martinimaturana/Tesis-CNC-Control-Inteligente/README.md

# Tesis-CNC-Control-Inteligente (REPOSITORIO EN PROCESO)
Código fuente, modelos y telemetría de una plataforma CNC de arquitectura abierta (Raspberry Pi + ESP32) para la evaluación de controladores PID, FLC y ANFIS a 1 kHz.
