martinimaturana/Tesis-CNC-Control-Inteligente/hardware/Imagenes/acople_iman_nema11.png

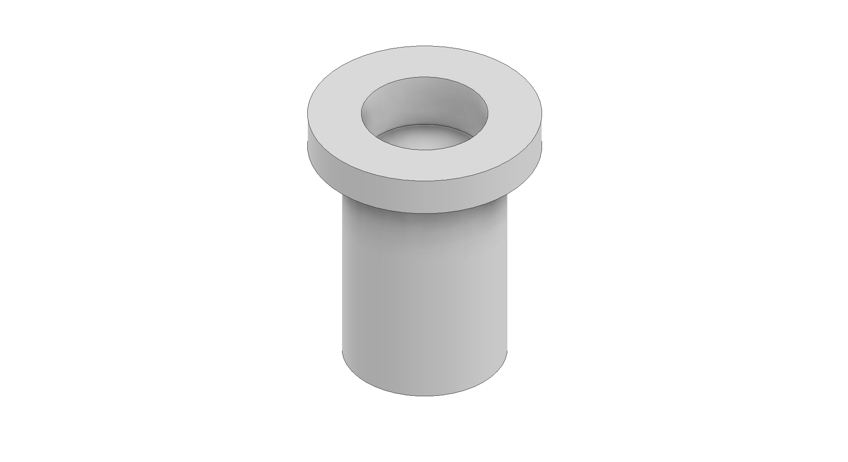
hardware/Imagenes/acople_iman_nema11.png
