martinimaturana/Tesis-CNC-Control-Inteligente/hardware/Imagenes/acople_iman_nema11_real.jpeg

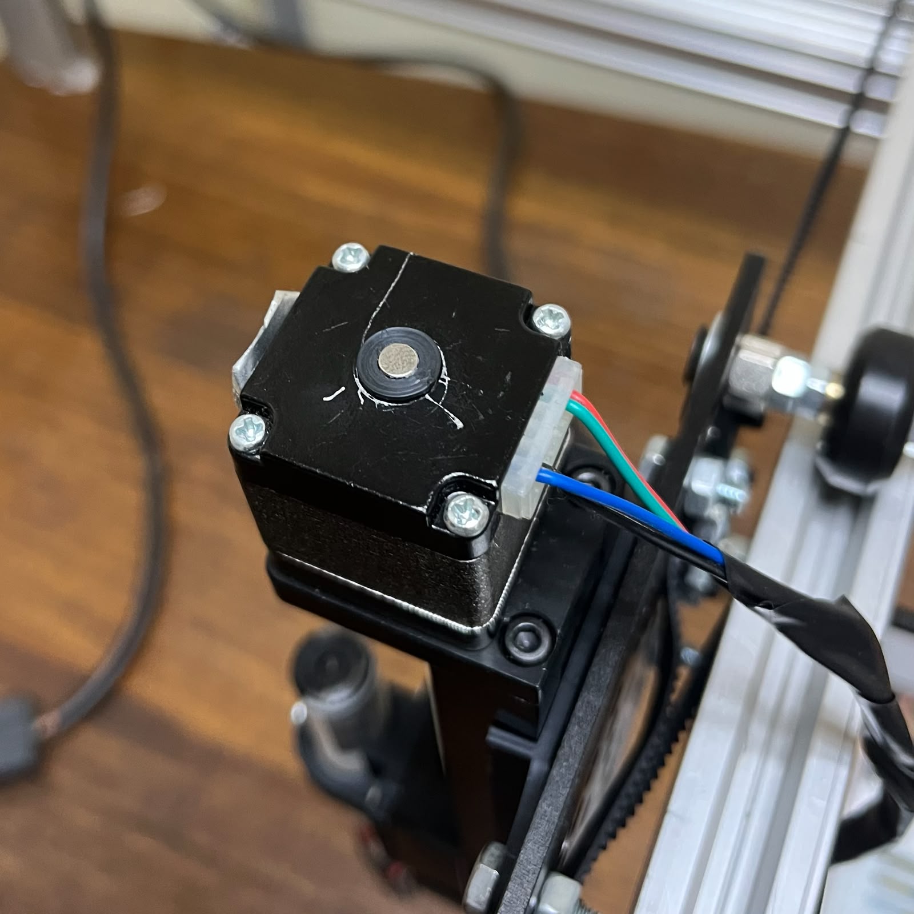
hardware/Imagenes/acople_iman_nema11_real.jpeg
