martinimaturana/Tesis-CNC-Control-Inteligente/hardware/Imagenes/acople_iman_nema23.png

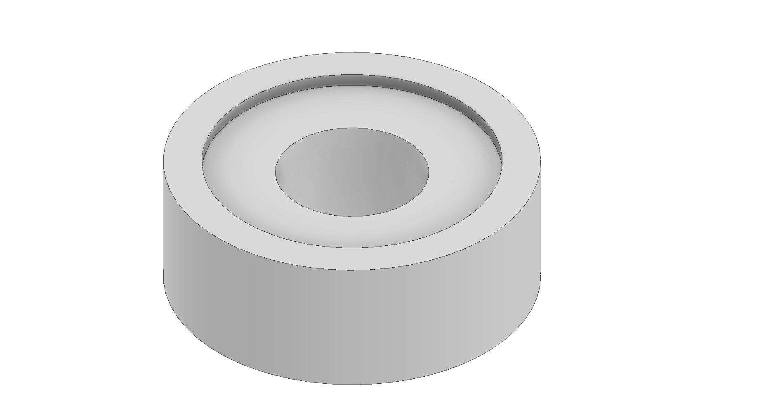
hardware/Imagenes/acople_iman_nema23.png
