martinimaturana/Tesis-CNC-Control-Inteligente/hardware/Imagenes/acople_iman_nema23_real.jpeg

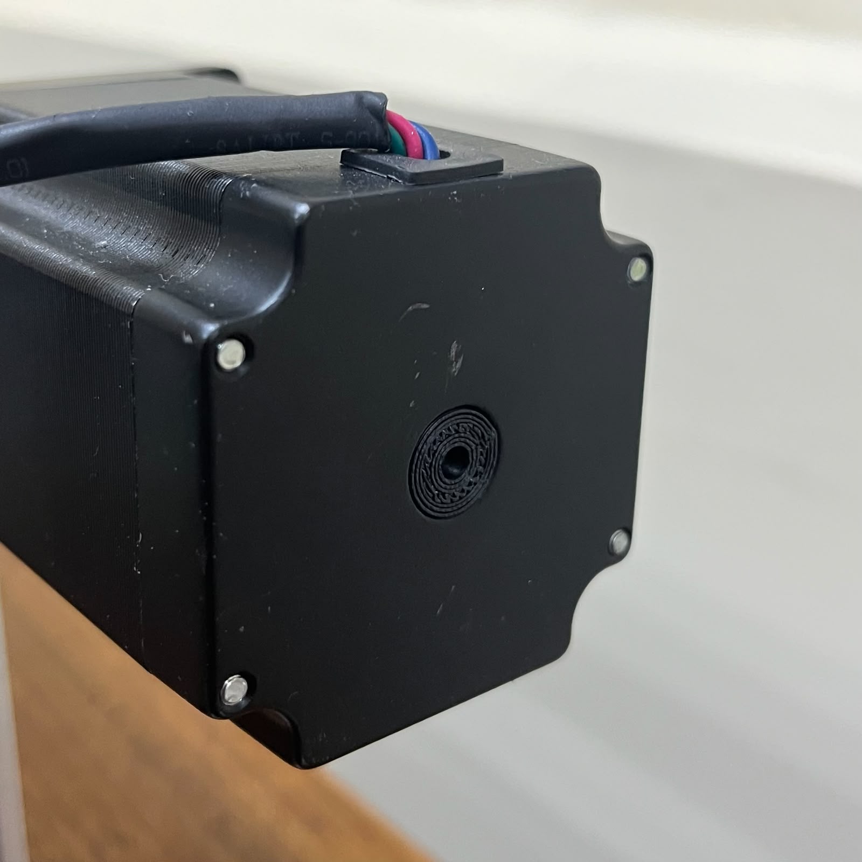
hardware/Imagenes/acople_iman_nema23_real.jpeg
