martinimaturana/Tesis-CNC-Control-Inteligente/hardware/Imagenes/driver_tb6600.jpg

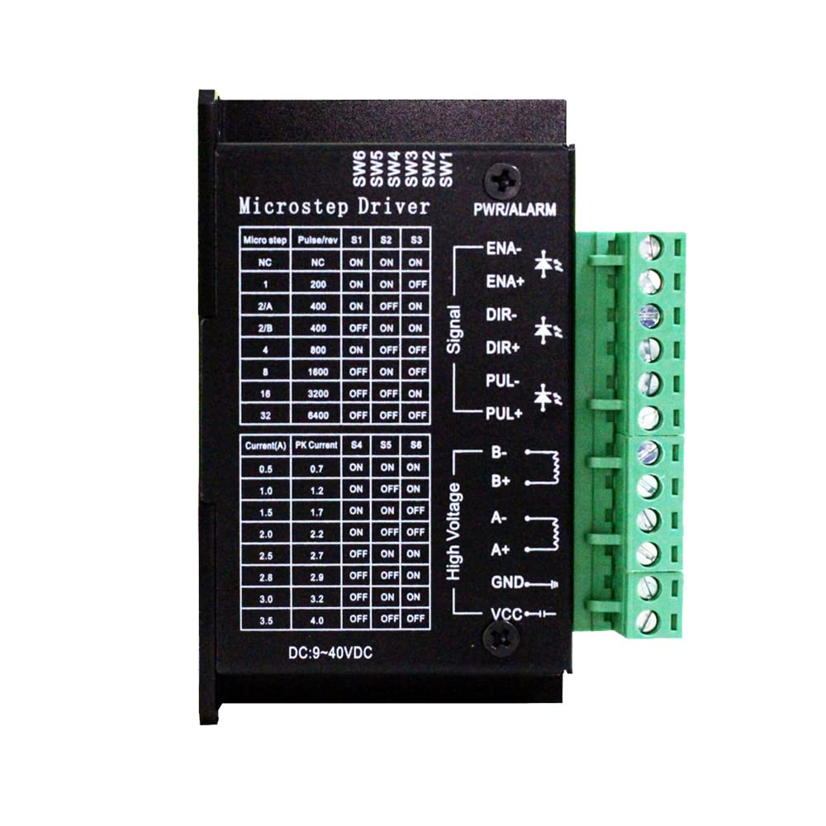
hardware/Imagenes/driver_tb6600.jpg
