martinimaturana/Tesis-CNC-Control-Inteligente/hardware/Imagenes/fuente_24v.jpg

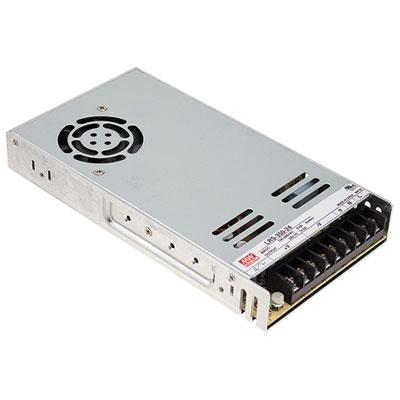
hardware/Imagenes/fuente_24v.jpg
