martinimaturana/Tesis-CNC-Control-Inteligente/hardware/Imagenes/modulo_xl4016.jpg

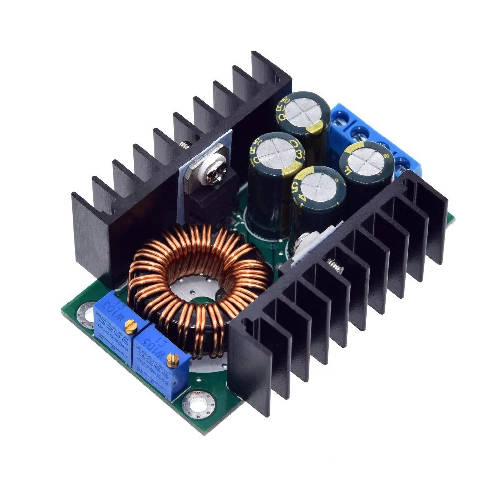
hardware/Imagenes/modulo_xl4016.jpg
