martinimaturana/Tesis-CNC-Control-Inteligente/hardware/Imagenes/raspberry_pi_4_b.png

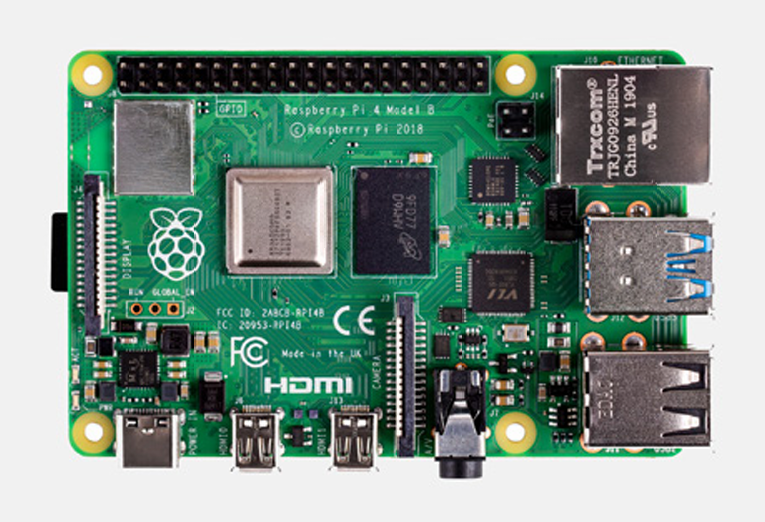
hardware/Imagenes/raspberry_pi_4_b.png
