martinimaturana/Tesis-CNC-Control-Inteligente/hardware/COSTOS_CNC.xlsx

Componentes CNC
N° | Componente | Cantidad | Precio Unitario | Total
1 | Motor Paso a paso Nema17 17HS3401S | 1 | $12000 | $12000
2 | ESP32 Devkit V1 30 Pines | 1 | $8000 | $8000
3 | Correa dentada GT2-6 100mm | 2 | $1000 | $2000
4 | Cables dupont macho macho | 40 | $30 | $1200
5 | Cables dupont macho hemnbra | 40 | $30 | $1200
6 | Cables dupont hembra hembra | 40 | $30 | $1200
7 | Encoder magnetico AS5600 | 3 | $1982.25 | $5946.75
8 | Perfil aluminio 40x20x700 | 1 | $11500 | $11500
9 | Perfil aluminio 40x40x35 | 1 | $2800 | $2800
10 | Kit Actuador C-Beam XL 1000 | 2 | $182000 | $364000
11 | 1kg Filamento PLA+ ENDER NEGRO | 1 | $10990 | $10990
12 | Polea dentada GT2-20 | 1 | $1200 | $1200
13 | Cables dupont 4 pines hembra hembra 70 cm | 2 | $1500 | $3000
14 | Cables dupont 3 pines hembra hembra 70 cm | 4 | $1500 | $6000
15 | Riel lineal T-type 100mm | 1 | $23720 | $23720
16 | Placa ranura V-Slot 20-80mm | 1 | $10672 | $10672
17 | Repartidor Bipolar 125a 7 Polos | 1 | $5350 | $5350
18 | Driver TTB6600 | 4 | $10290 | $41160
19 | INA219 | 4 | $2500 | $10000
20 | Fuente de Poder Mean Well LRS-350-24 – 350W 24VDC 14.6A | 1 | $29780 | $29780
21 | Raspberry pi 4 Model B 4GB RAM | 1 | $145990 | $145990
22 | Riel Din Perforado 35X7,5Mm Tira 1Mts | 1 | $1850 | $1850
23 | Canaleta ranurada W20XH30 2m Gris | 1 | $2850 | $2850
24 | Interruptor automático 1X16A | 1 | $5000 | $5000
25 | Módulo XL4016 300W 9A Step Down | Fuente CV/CC Ajustable | 1 | $5600 | $5600
26 | Mini protoboard 170 puntos | 1 | $990 | $990
27 | Tarjeta de Expansión con Borneras para ESP32 Versión 30 Pines | 1 | $3600 | $3600
28 | Pizarra Blanca 600x900 | 1 | $12480 | $12480
 |  |  | TOTAL | $730078.75
