martinimaturana/Tesis-CNC-Control-Inteligente/hardware/STLs hardware mecanico/acople as5600 nema17.stl

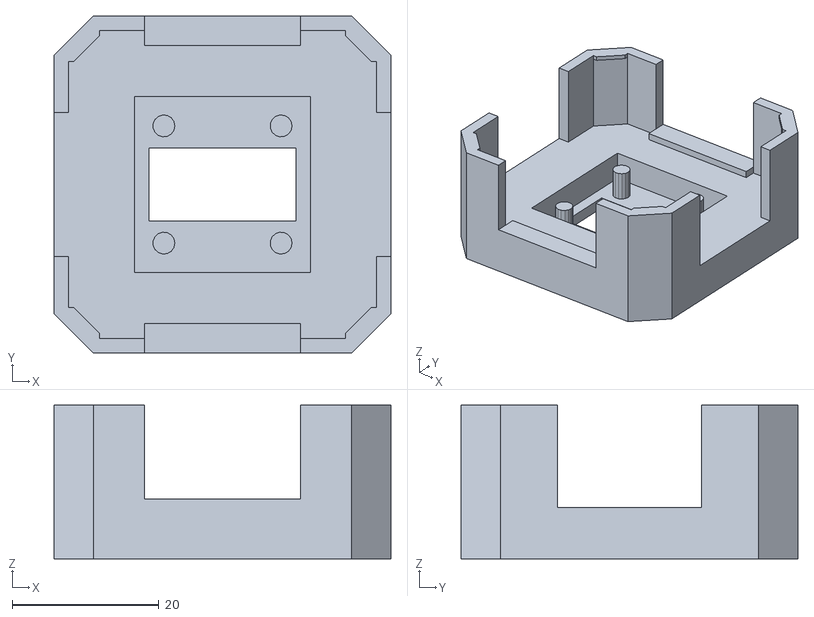
[picture p44: CAD file, 2026-09-17]
hardware/STLs hardware mecanico/acople as5600 nema17.stl
46.0 x 46.0 x 21.0
