martinimaturana/Tesis-CNC-Control-Inteligente/hardware/tablero_electrico/3D_STL_TABLERO/soporte fuente de poder.stl

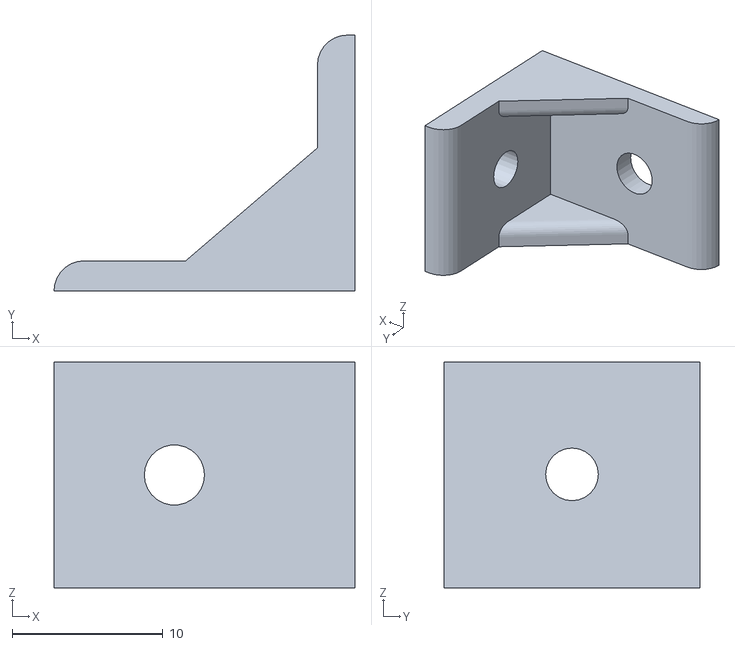
[picture p45: CAD file, 2026-09-18]
hardware/tablero_electrico/3D_STL_TABLERO/soporte fuente de poder.stl
20.0 x 17.0 x 15.0
