martinimaturana/Tesis-CNC-Control-Inteligente/hardware/STLs hardware mecanico/soporte iman nema23.stl

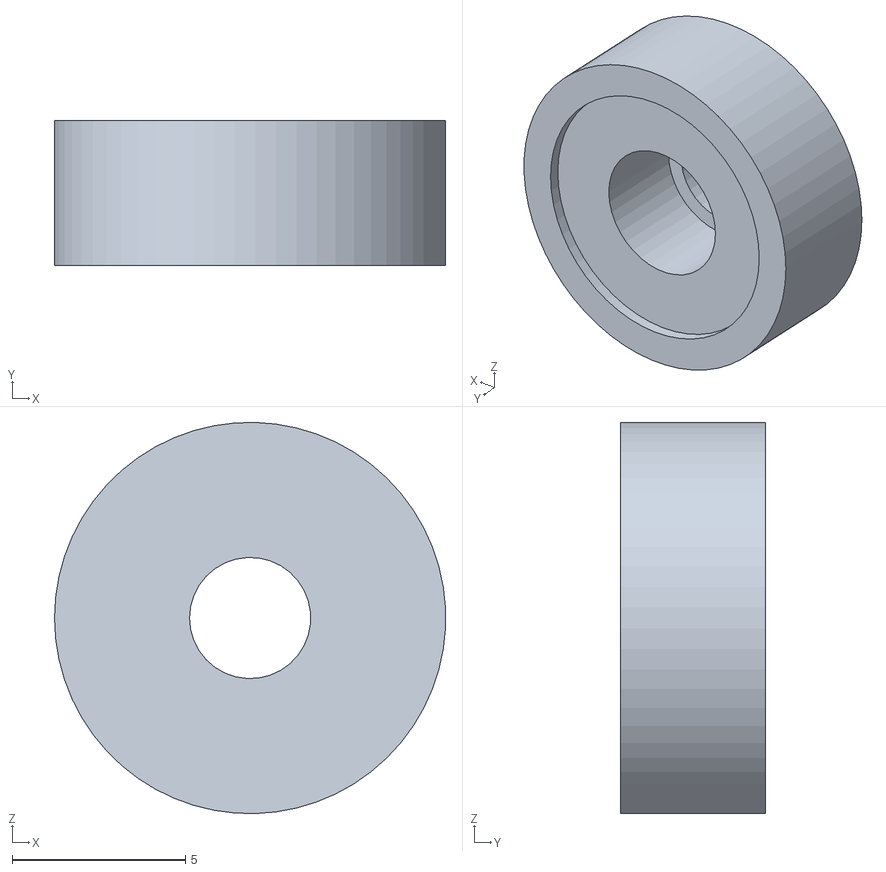
[picture p46: CAD file, 2026-09-17]
hardware/STLs hardware mecanico/soporte iman nema23.stl
11.3 x 4.20 x 11.3
