martinimaturana/Tesis-CNC-Control-Inteligente/hardware/tablero_electrico/3D_STL_TABLERO/INA219_RIEL_DIN.stl

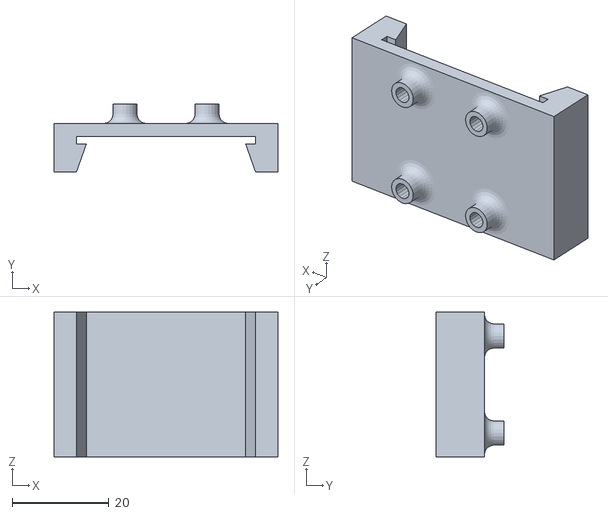
[picture p47: CAD file, 2026-09-18]
hardware/tablero_electrico/3D_STL_TABLERO/INA219_RIEL_DIN.stl
46.4 x 14.0 x 30.0
