martinimaturana/Tesis-CNC-Control-Inteligente/hardware/STLs hardware mecanico/acople as5600 nema11.stl

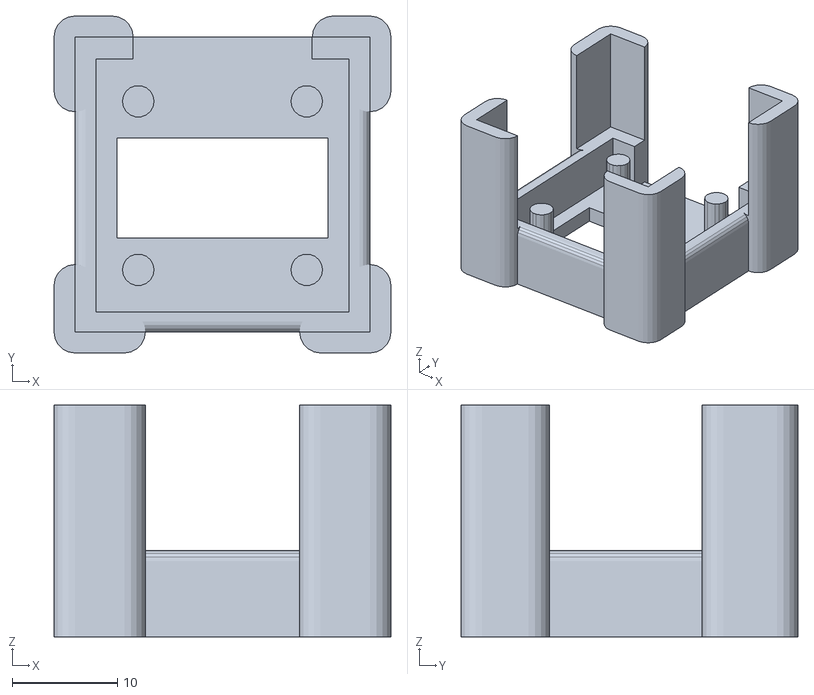
[picture p48: CAD file, 2026-09-17]
hardware/STLs hardware mecanico/acople as5600 nema11.stl
32.0 x 32.0 x 22.0
