martinimaturana/Tesis-CNC-Control-Inteligente/hardware/tablero_electrico/3D_STL_TABLERO/ESP32_RIEL_DIN.stl

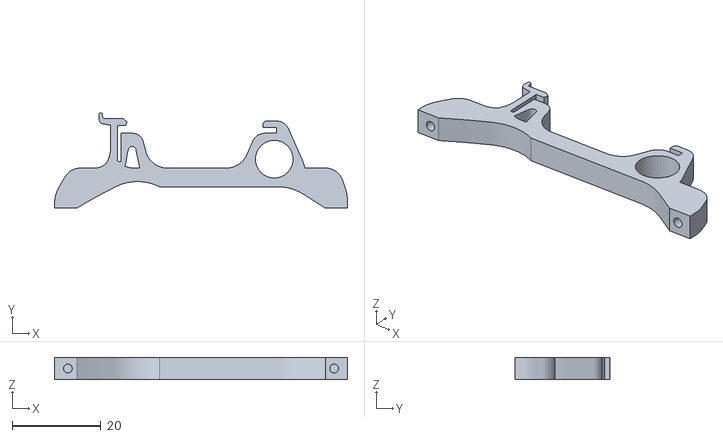
[picture p49: CAD file, 2026-09-18]
hardware/tablero_electrico/3D_STL_TABLERO/ESP32_RIEL_DIN.stl
66.0 x 21.5 x 5.00
