martinimaturana/Tesis-CNC-Control-Inteligente/hardware/STLs hardware mecanico/soporte_iman_nema17.stl

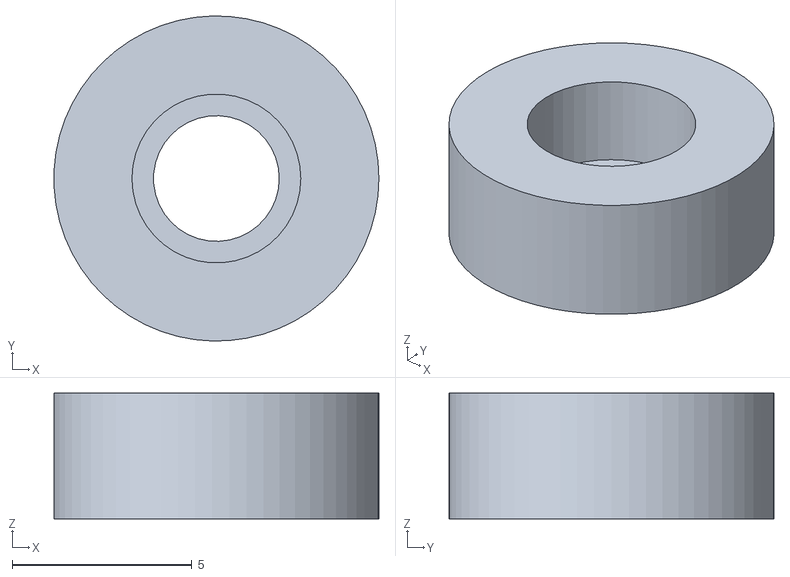
[picture p50: CAD file, 2026-09-17]
hardware/STLs hardware mecanico/soporte_iman_nema17.stl
9.04 x 9.05 x 3.50
