martinimaturana/Tesis-CNC-Control-Inteligente/hardware/tablero_electrico/3D_STL_TABLERO/DC-DC_RIEL_DIN.stl

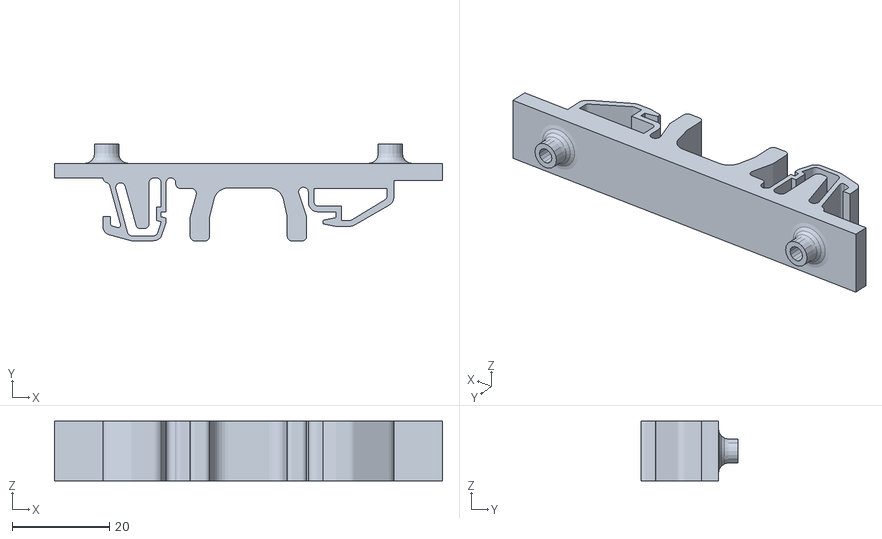
[picture p51: CAD file, 2026-09-18]
hardware/tablero_electrico/3D_STL_TABLERO/DC-DC_RIEL_DIN.stl
80.0 x 20.0 x 12.3
