martinimaturana/Tesis-CNC-Control-Inteligente/hardware/STLs hardware mecanico/acople correa gt2 6mm - carro eje y.stl

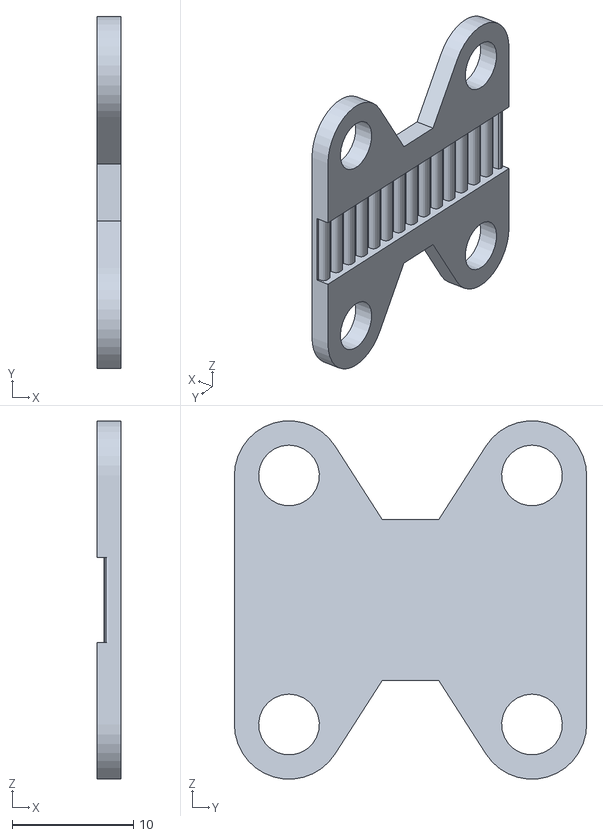
[picture p52: CAD file, 2026-09-17]
hardware/STLs hardware mecanico/acople correa gt2 6mm - carro eje y.stl
2.00 x 29.0 x 29.5
