martinimaturana/Tesis-CNC-Control-Inteligente/hardware/STLs hardware mecanico/acople as5600 nema23.stl

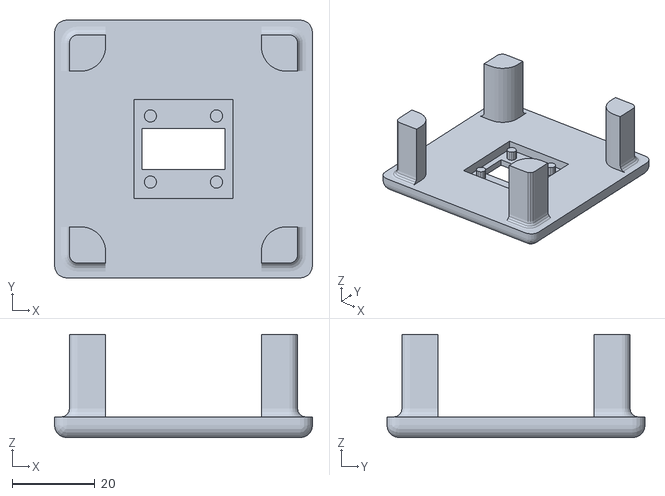
[picture p53: CAD file, 2026-09-17]
hardware/STLs hardware mecanico/acople as5600 nema23.stl
62.5 x 62.5 x 25.0
