martinimaturana/Tesis-CNC-Control-Inteligente/hardware/STLs hardware mecanico/acople perfil 4040 nema17.stl

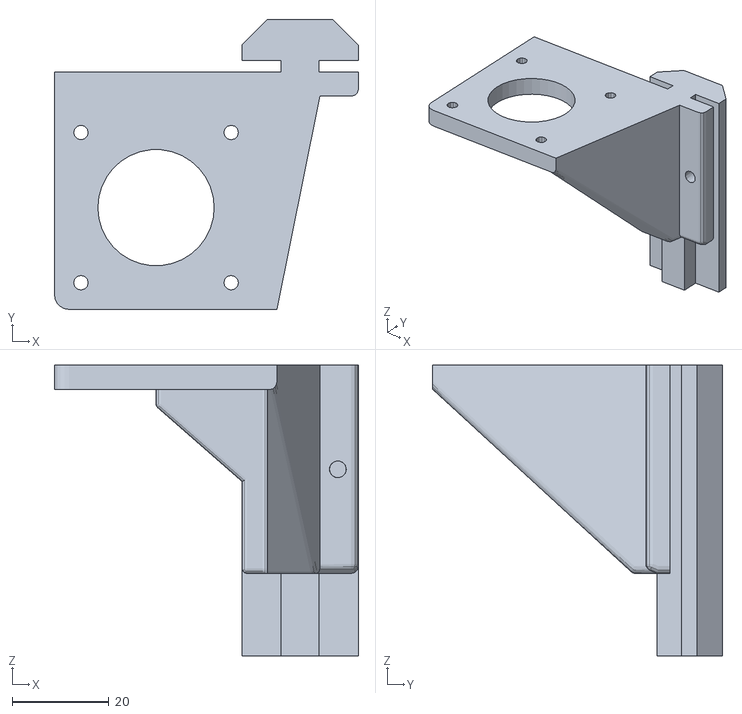
[picture p54: CAD file, 2026-09-17]
hardware/STLs hardware mecanico/acople perfil 4040 nema17.stl
62.7 x 59.8 x 60.0
