martinimaturana/Tesis-CNC-Control-Inteligente/hardware/STLs hardware mecanico/soporte iman nema11.stl

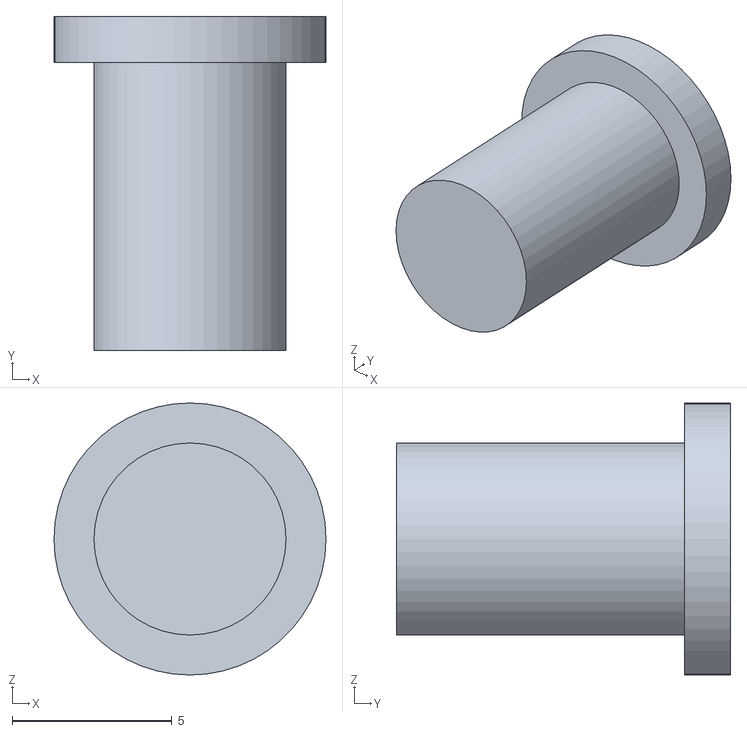
[picture p55: CAD file, 2026-09-17]
hardware/STLs hardware mecanico/soporte iman nema11.stl
8.50 x 10.4 x 8.50
