martinimaturana/Tesis-CNC-Control-Inteligente/hardware/STLs hardware mecanico/acople lapiz marcador.stl

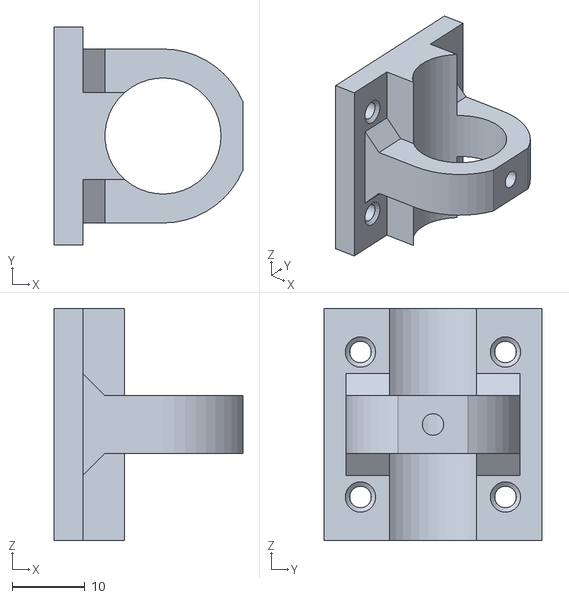
[picture p56: CAD file, 2026-09-17]
hardware/STLs hardware mecanico/acople lapiz marcador.stl
26.0 x 30.0 x 32.0
