martinimaturana/Tesis-CNC-Control-Inteligente/hardware/STLs hardware mecanico/acople polea suelta v2.stl

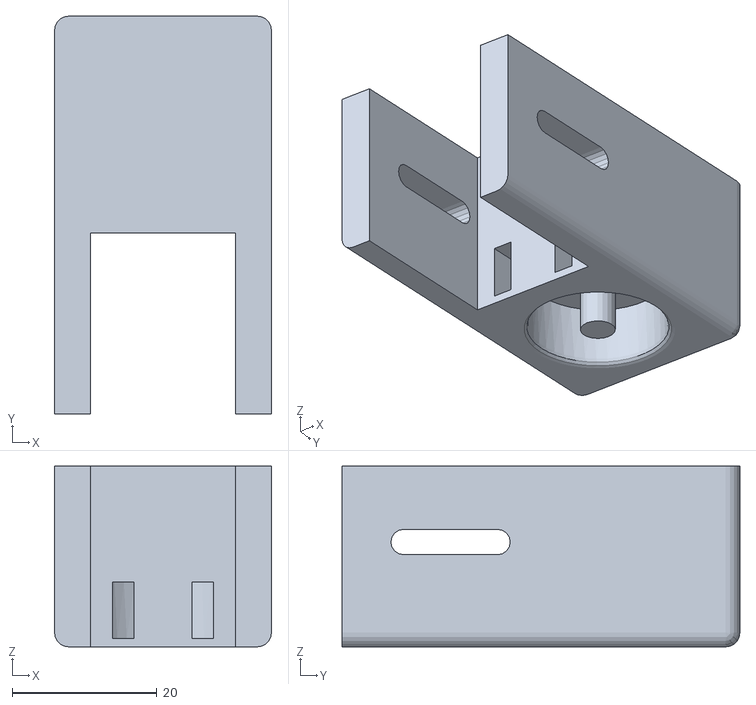
[picture p57: CAD file, 2026-09-17]
hardware/STLs hardware mecanico/acople polea suelta v2.stl
30.0 x 55.0 x 25.0
