martinimaturana/Tesis-CNC-Control-Inteligente/hardware/STLs hardware mecanico/acople eje z a carro eje y.stl

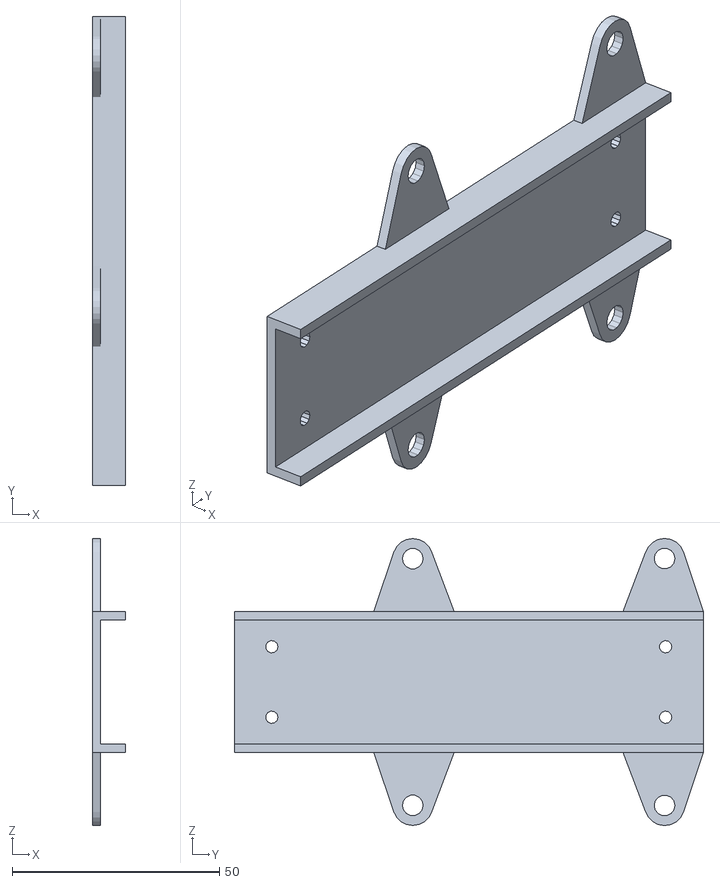
[picture p58: CAD file, 2026-09-17]
hardware/STLs hardware mecanico/acople eje z a carro eje y.stl
8.00 x 113.1 x 69.3
